diffstorm/WiFiMifareReader/README.md

# WiFiMifareReader
Wi-Fi featured IoT Mifare Card Reader with improved security and logging features
