diffstorm/WiFiMifareReader/HW/Reader/Images/door_lock_v1.1.png

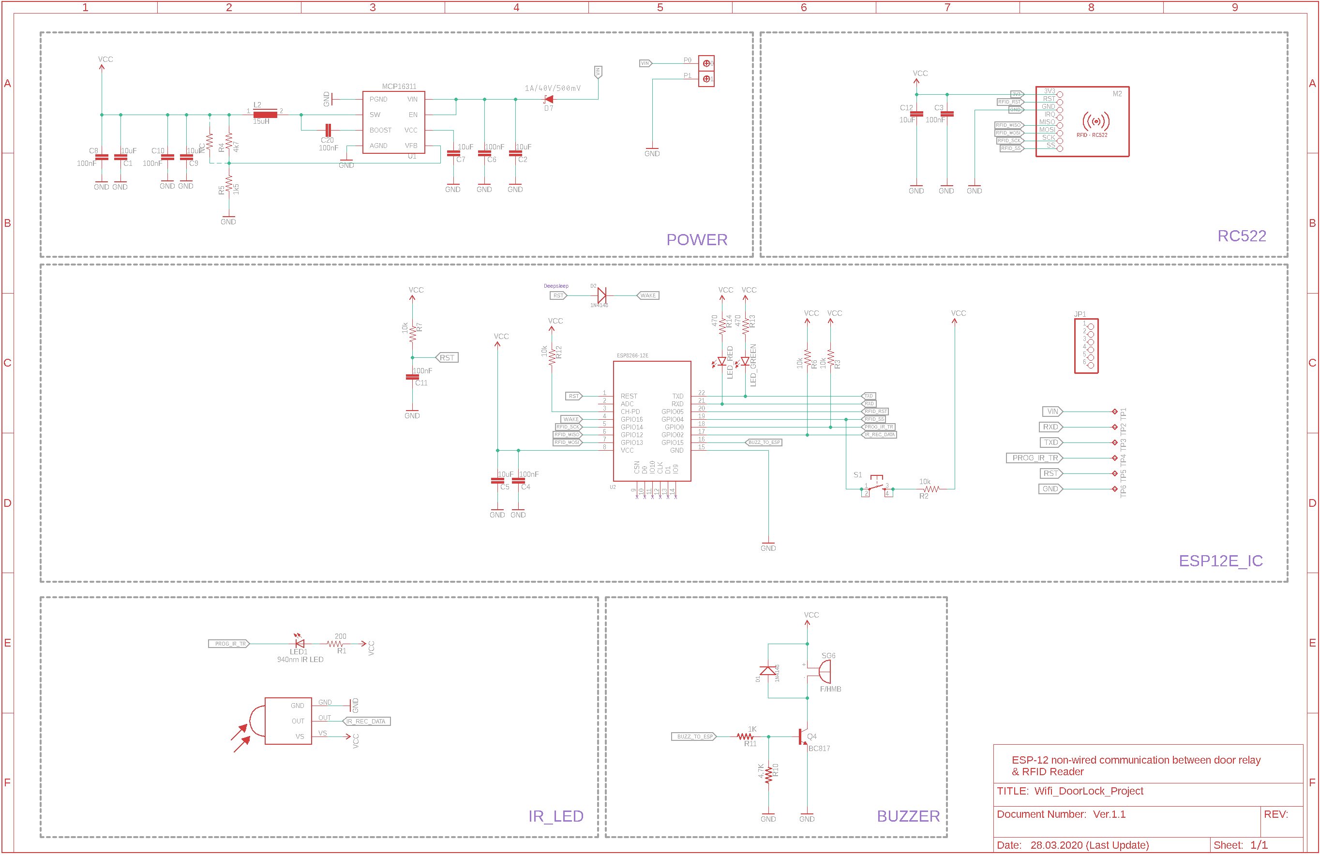
HW/Reader/Images/door_lock_v1.1.png
