diffstorm/WiFiMifareReader/HW/Relay/Images/Relay_schematic.png

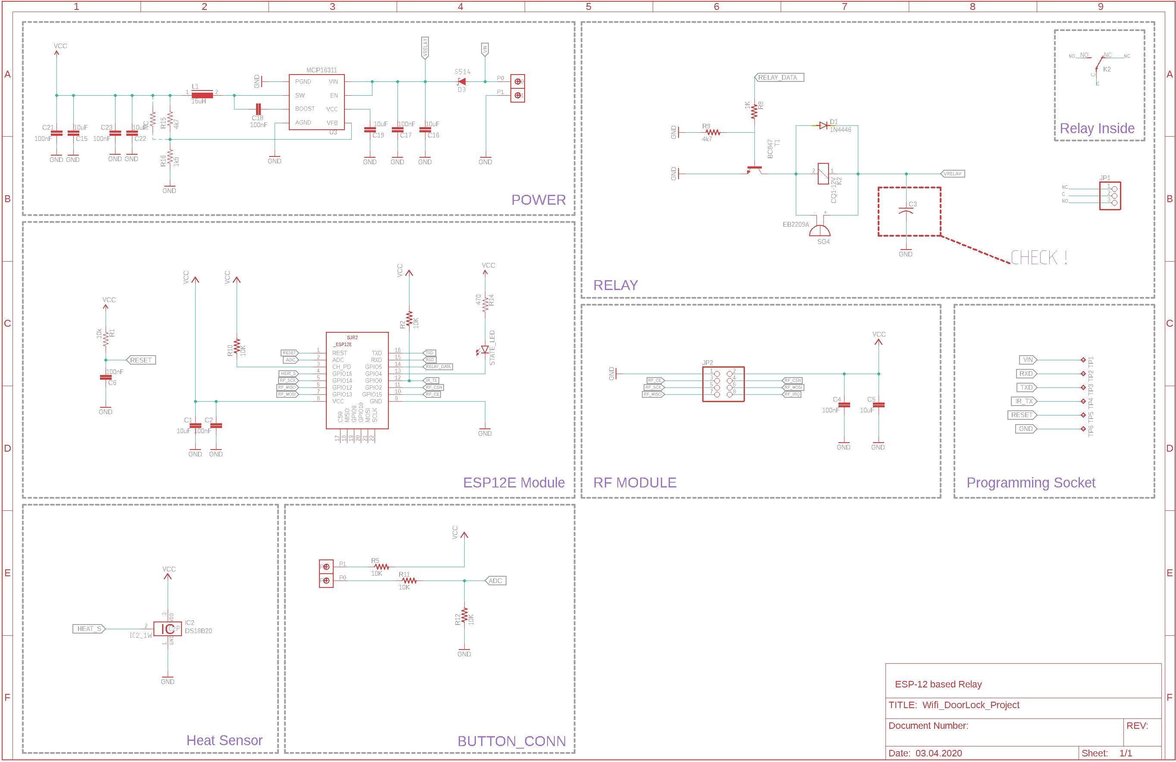
HW/Relay/Images/Relay_schematic.png
