diffstorm/WiFiMifareReader/HW/Reader/Eagle/flasher.brd

## EAGLE design HW/Reader/Eagle/flasher.brd (2020-04-13)

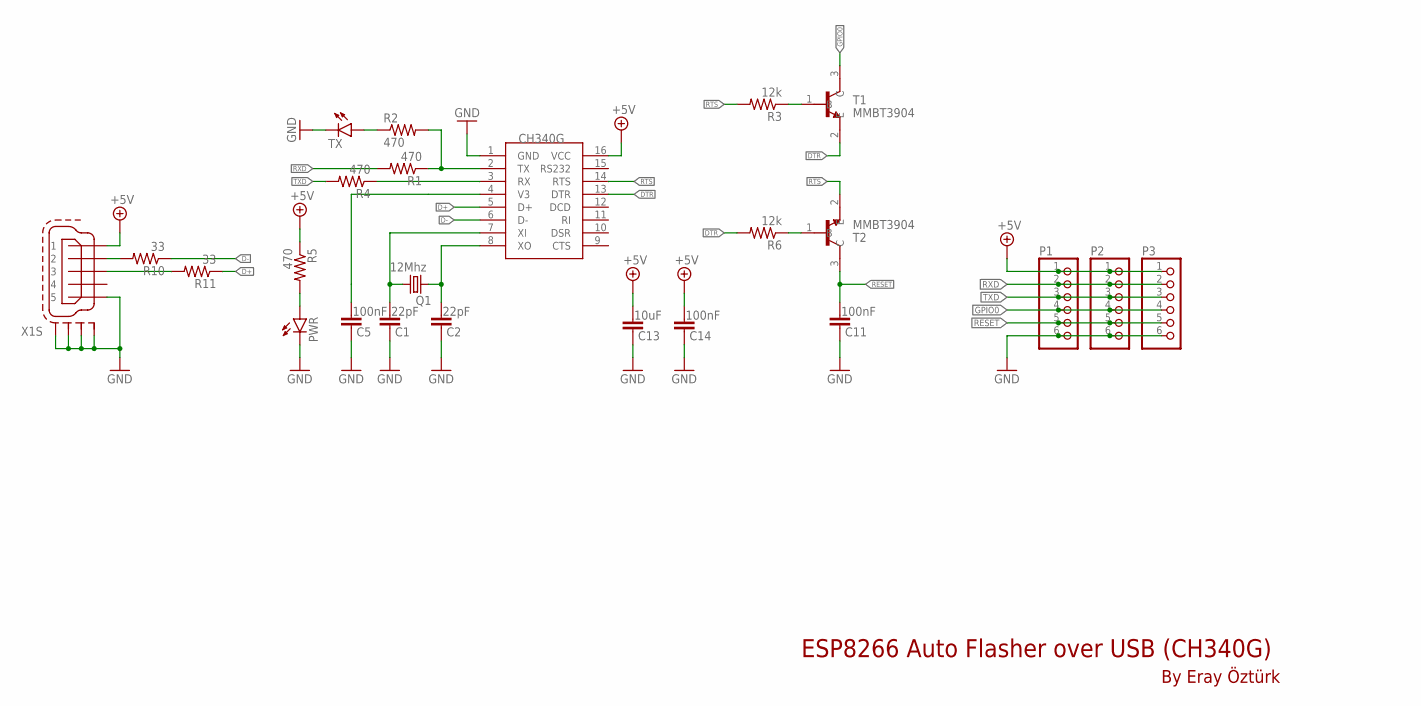
[picture p9: schematic flasher.sch]

Parts:
C1, C2: 22pF; C0805
C5, C11, C14: 100nF; C0805
C13: 10uF; C0805
P1, P2, P3: PINHD-1X6; 1X06
PWR: LEDCHIP-LED0805; CHIP-LED0805
Q1: 12Mhz; HC49/S
R1, R2, R4, R5: 470; M0805
R3, R6: 12k; M0805
R10, R11: 33; M0805
T1, T2: MMBT3904; SOT95P240X120-3N
TX: LEDCHIP-LED0805; CHIP-LED0805
U1: CH340G; SOIC16
X1: MINI-USB-SCHIELD-32005-201; 32005-201

Connections:
+5V: C13.2, C14.2, P1.1, P2.1, P3.1, R5.1, U1.16 (VCC), X1.1
D+: R11.1, U1.5 (D+)
D-: R10.1, U1.6 (D-)
DTR: R6.2, T1.2 (E), U1.13 (DTR)
GND: C1.1, C2.1, C5.1, C11.1, C13.1, C14.1, P1.6, P2.6, P3.6, PWR.C, TX.C, U1.1 (GND), X1.5, X1.M1 (S1), X1.M2 (S2), X1.M3 (S3), X1.M4 (S4)
GPIO0: P1.4, P2.4, P3.4, T1.3 (C)
unnamed: R1.1, R2.2, U1.2 (TX)
unnamed: R4.1, U1.3 (RX)
unnamed: PWR.A, R5.2
unnamed: R2.1, TX.A
unnamed: R3.1, T1.1 (B)
unnamed: R6.1, T2.1 (B)
unnamed: R10.2, X1.2
unnamed: R11.2, X1.3
unnamed: C5.2, U1.4 (V3)
unnamed: C1.2, Q1.1, U1.7 (XI)
unnamed: C2.2, Q1.2, U1.8 (XO)
RESET: C11.2, P1.5, P2.5, P3.5, T2.3 (C)
RTS: R3.2, T2.2 (E), U1.14 (RTS)
RXD: P1.2, P2.2, P3.2, R1.2
TXD: P1.3, P2.3, P3.3, R4.2

Notes on the sheet:
ESP8266 Auto Flasher over USB (CH340G)
By Eray Öztürk

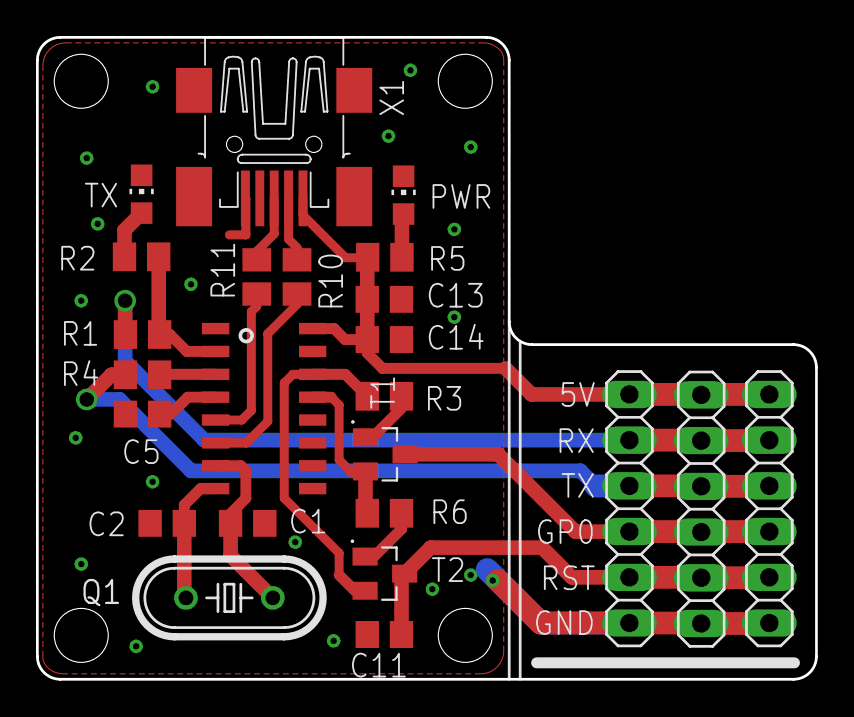
[picture p10: board flasher.brd from above]

Board: 2 copper layers, 43.3 x 35.7 mm, 24 parts (0 on the bottom side), 21 nets.
