diffstorm/WiFiMifareReader/HW/Relay/Eagle/relay.sch

## EAGLE design HW/Relay/Eagle/relay.sch (2020-04-29)

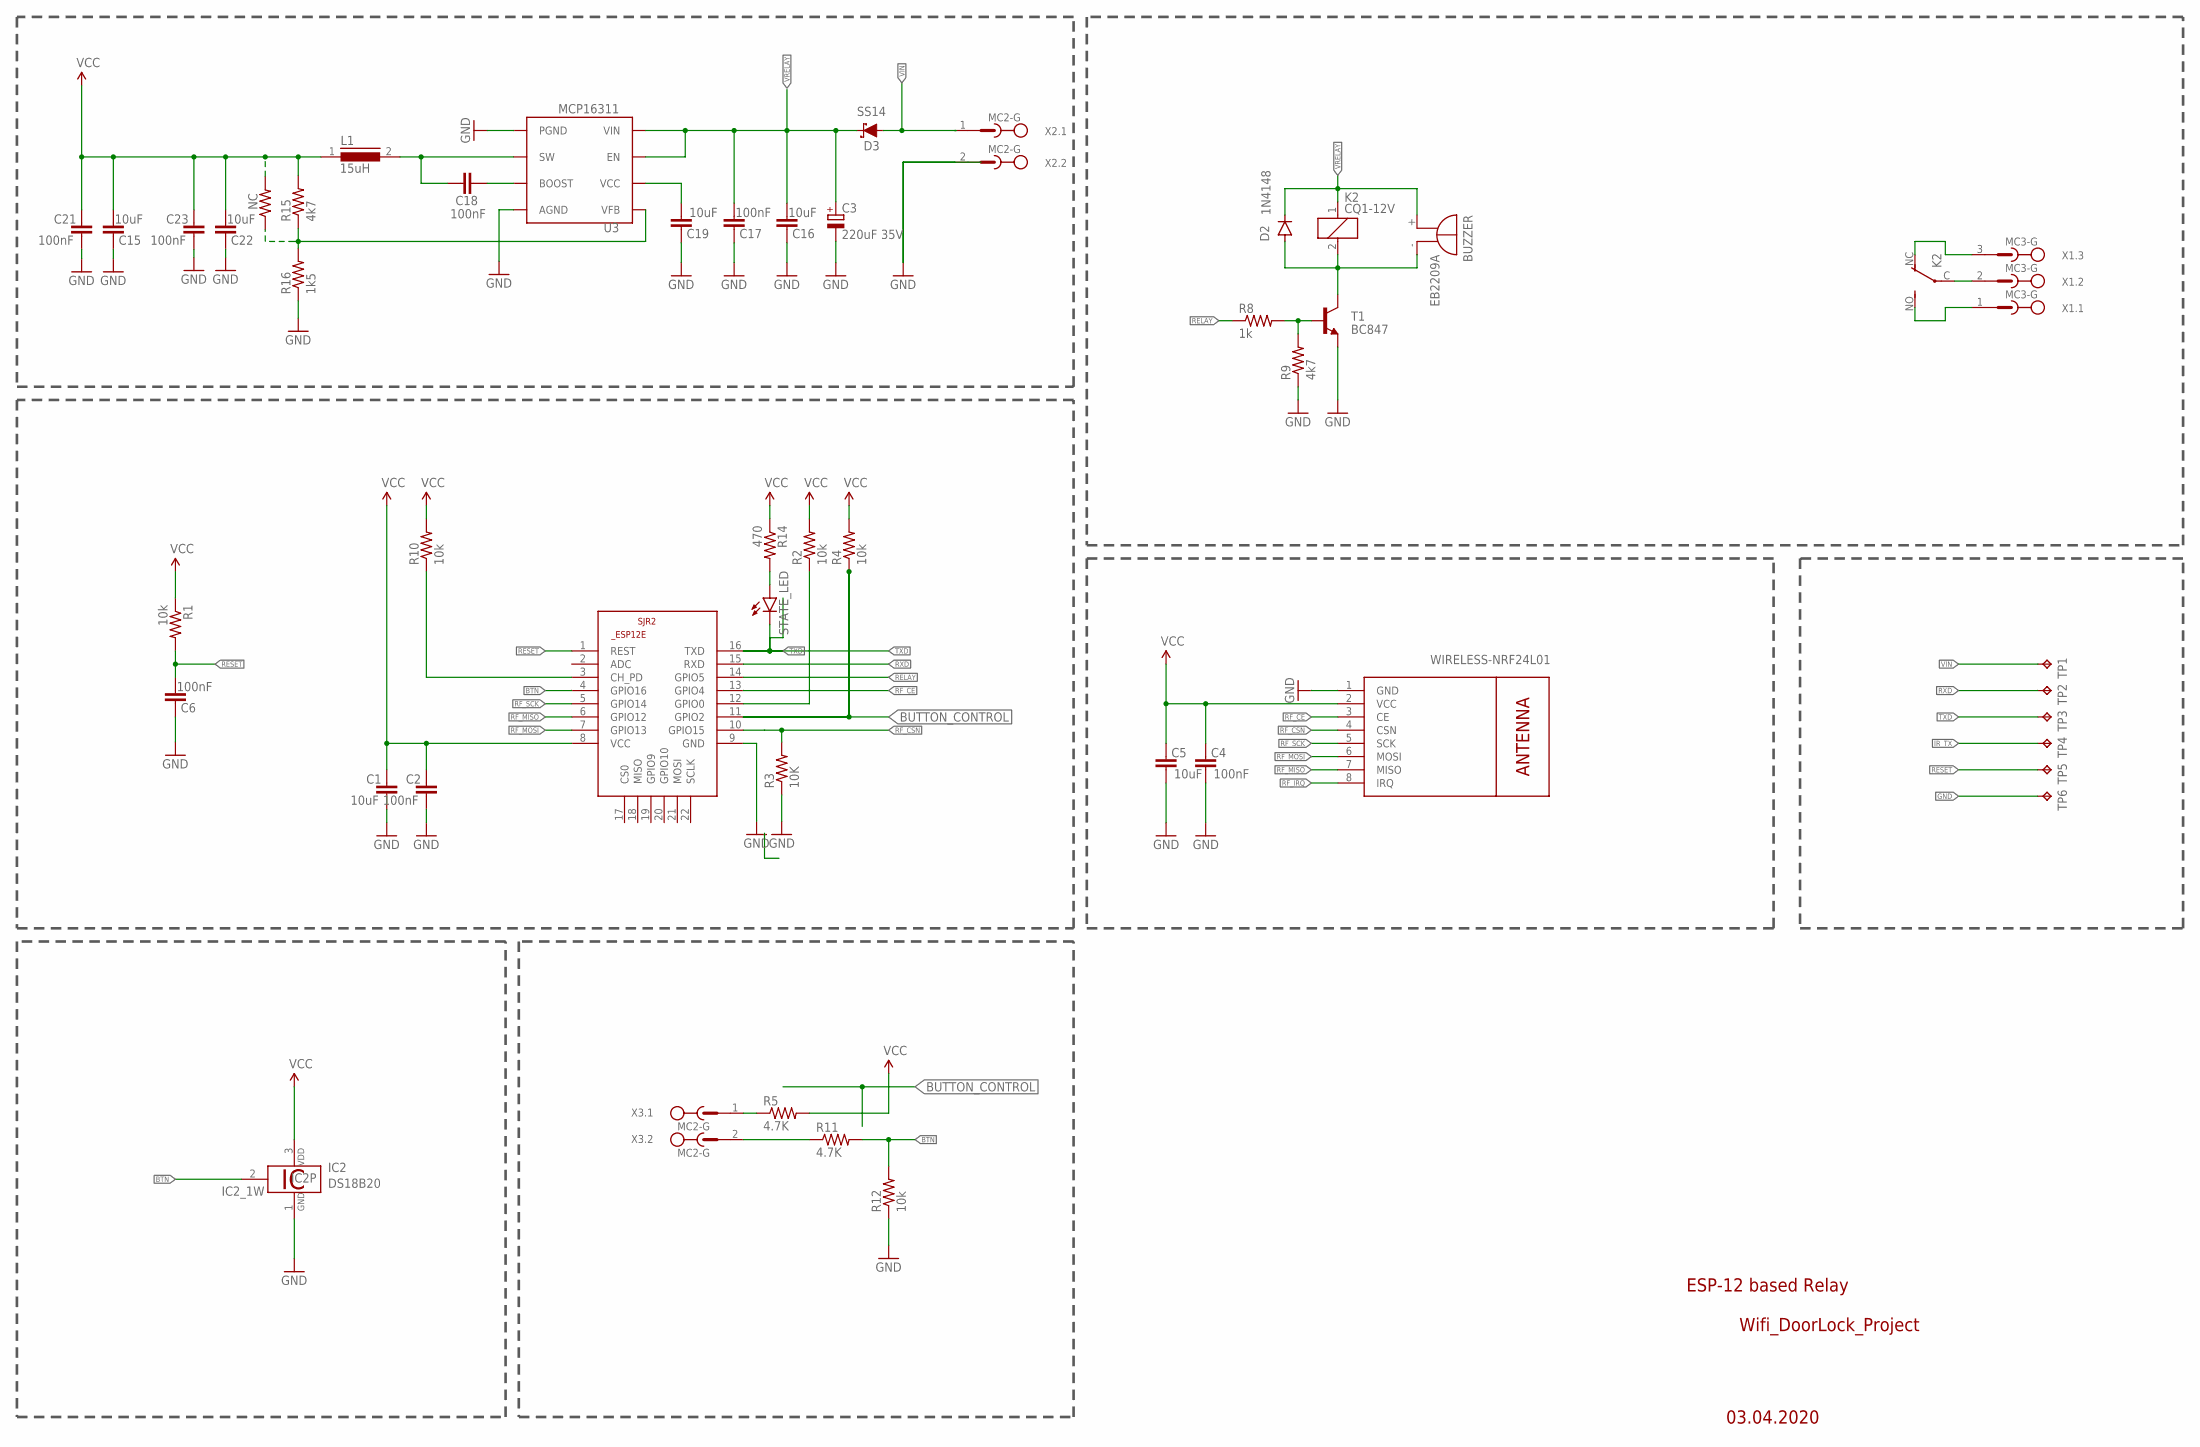
[picture p11: schematic relay.sch]

Parts:
BUZZER: EB2209A
C1, C5, C15, C16, C19, C22: 10uF; C0805
C2, C4, C6, C17, C18, C21, C23: 100nF; C0805
C3: 220uF 35V; 150CLZ-0810
D2: 1N4148; DO-214AC
D3: SS14; SMA-DIODE
IC2: DS18B20; TO92-
K2: CQ1-12V; CQ1
L1: 15uH; DR74
M1: WIRELESS-NRF24L01
NC: R-US_M0805; M0805
R1, R2, R4, R10, R12: 10k; M0805
R3: 10K; M0805
R5, R11: 4.7K; M0805
R8: 1k; M0805
R9, R15: 4k7; M0805
R14: 470; M0805
R16: 1k5; M0805
SJR2: ESP8266-12EESP12E; ESP8266-ESP12E
STATE_LED: LED3MM
T1: BC847; SOT23
TP1, TP2, TP3, TP4, TP5, TP6: TPTP20SQ; TP20SQ
U3: MCP16311; MSOP8
X1: MC3-G
X2, X3: MC2-G

Connections:
BTN: IC2.2 (1W), R11.2, R12.2, SJR2.4 (GPIO16)
BUTTON_CONTROL: R2.1, R11.2, R12.2, SJR2.11 (GPIO2)
G2: R4.1, SJR2.11 (GPIO2)
GND: C1.2, C2.2, C3.-, C4.2, C5.2, C6.1, C15.1, C16.1, C17.1, C19.1, C21.2, C22.1, C23.2, IC2.1 (GND), M1.1 (GND), R3.1, R9.1, R12.1, R16.1, SJR2.9 (GND), T1.2 (E), TP6.TP, U3.AGND, U3.PGND, X2.2
IR_TX: TP4.TP
unnamed: R8.2, R9.2, T1.1 (B)
unnamed: K2.C, X1.2
unnamed: NC.1, R15.1, R16.2, U3.VFB
unnamed: R14.2, STATE_LED.A
unnamed: BUZZER.-, D2.A, K2.2, T1.3 (C)
unnamed: K2.NC (O), X1.3
unnamed: K2.NO (S), X1.1
unnamed: R2.1, SJR2.12 (GPIO0)
unnamed: R5.1, X3.1
unnamed: R11.1, X3.2
unnamed: C18.2, L1.2, U3.SW
unnamed: C18.1, U3.BOOST
unnamed: C19.2, U3.VCC
unnamed: R10.1, SJR2.3 (CH_PD)
RELAY: R8.1, SJR2.14 (GPIO5)
RESET: C6.2, R1.2, SJR2.1 (REST), TP5.TP
RF_CE: M1.3 (CE), SJR2.13 (GPIO4)
RF_CSN: M1.4 (CSN), R3.2, SJR2.10 (GPIO15)
RF_IRQ: M1.8 (IRQ)
RF_MISO: M1.7 (MISO), SJR2.6 (GPIO12)
RF_MOSI: M1.6 (MOSI), SJR2.7 (GPIO13)
RF_SCK: M1.5 (SCK), SJR2.5 (GPIO14)
RXD: SJR2.15 (RXD), TP2.TP
TXD: SJR2.16 (TXD), STATE_LED.K (C), TP3.TP
VCC: C1.1, C2.1, C4.1, C5.1, C15.2, C21.1, C22.2, C23.1, IC2.3 (VDD), L1.1, M1.2 (VCC), NC.2, R1.1, R2.2, R4.2, R5.2, R10.2, R14.1, R15.2, SJR2.8 (VCC)
VIN: D3.A, TP1.TP, X2.1
VRELAY: BUZZER.+, C3.+, C16.2, C17.2, D2.C, D3.C, K2.1, U3.EN, U3.VIN

Notes on the sheet:
ESP-12 based Relay
Wifi_DoorLock_Project
03.04.2020
