diffstorm/WiFiMifareReader/SW/Reader/v1/src/DebugLog.cpp

#include <Arduino.h>
#include <DebugLog.h>

void DBG_LOG_Init(unsigned long baudrate)
{
    Serial.begin(baudrate);
}

// Printout: message [int, float, double, hex] | <function_name> @ <file_name> : <line>

void DBG_LOG_tail(const char *func, const char *loc)
{
    Serial.print(" | ");
    Serial.print(func);
    Serial.println(loc);
}

#if 0
void DBG_LOG(const char *message, const char *func, const char *loc, int *i, float *f, double *d, char *hex, int hex_size)
{
    Serial.print(message);
    if(NULL != i)
    {
        Serial.print(" ");
        Serial.print(*i);
    }
    else if(NULL != f)
    {
        Serial.print(" ");
        Serial.print(*f);
    }
    else if(NULL != d)
    {
        Serial.print(" ");
        Serial.print(*d);
    }
    else if(NULL != hex && 0 < hex_size)
    {
        Serial.print(" [");
        for(int i = 0; i < hex_size; i++)
        {
            Serial.printf("%02X", hex[i]);

            if(i + 1 < hex_size)
            {
                Serial.print(", ");
            }
        }
        Serial.print("]");
    }
    DBG_LOG_tail(func, loc);
}
#else
void DBG_LOG(const char *message, const char *func, const char *loc, dl_type_t type, void *in, int size)
{
    Serial.print(message);
    switch (type)
    {
    case dl_int:
        {
            int *i = (int *)in;
            Serial.print(" ");
            Serial.print(*i);
        }
        break;
    case dl_float:
        {
            float *f = (float *)in;
            Serial.print(" ");
            Serial.print(*f);
        }
        break;
    case dl_double:
        {
            double *d = (double *)in;
            Serial.print(" ");
            Serial.print(*d);
        }
        break;
    case dl_hex:
        {
            unsigned char *hex = (unsigned char *)in;
            if(NULL != hex && 0 < size)
            {
                Serial.print(" [");
                for(int i = 0; i < size; i++)
                {
                    Serial.printf("%02X", hex[i]);

                    if(i + 1 < size)
                    {
                        Serial.print(", ");
                    }
                }
                Serial.print("]");
            }
        }
        break;
    default:
        break;
    }
    DBG_LOG_tail(func, loc);
}
#endif
