diffstorm/WiFiMifareReader/(commit log)

2020-03-09 led ve buzzer eklendi
    [Buzzer.cpp, Buzzer.h, Reader.cpp, led.cpp, led.h, main.cpp]
2020-03-09 led ve buzzer duzenlemeleri yapildi
    [Buzzer.cpp, Reader.cpp, Reader.h, led.cpp, main.cpp]
2020-03-09 ledpinleri tanımlandı
2020-03-09 timer duzeltildi
2020-03-10 SysTimer adding for led and buzzer
    [Buzzer.cpp, Buzzer.h, SysTick.cpp, led.cpp]
2020-03-10 led and buzzer solved
    [Buzzer.cpp, Buzzer.h, Reader.cpp, SysTick.cpp, led.cpp, main.cpp]
2020-03-11 Add files via upload
    Malzeme Listesi ve IR led dökümanları eklendi.
2020-03-12 eagle schematic is uploaded
    Eagle sch. documents only included reader and programmable part of first step.
    [PROG.sch, door_lock_v1.0.sch]
2020-03-28 Delete v1.0
    swap files with latest update v1.1
    [door_lock_v1.0.sch]
2020-03-28 swap files with lastest update v1.1
    [door_lock_v1.1.sch]
2020-03-28 WiFiReaderConfig - Add relay comm method
2020-03-28 Relay_config dosyası oluşturuldu.
2020-03-28 RelayConfig Değişti
2020-04-02 deleted old version of programming sch.
    [PROG.sch]
2020-04-02 deleted version of door_locks v1.1 sch.
    [door_lock_v1.1.sch]
2020-04-02 wifi_reader, program_reader sch. is changed
    Programlama pinleri değiştirildi, eklendi. door_lock_v1.2.sch üzerinde hatalar düzeltildir. Footprintler kontrol edildi.
    [door_lock_v1.2.sch, program_v1.2.sch]
2020-04-02 Minor improvements on schematic
    [door_lock_v1.2.sch]
2020-04-03 relay_sch updated.
    Relay sch, Programming sch, sch. image are updated.
    [program_v1.2.sch, relay.sch]
2020-04-03 deleting relay.pro
    not usable for now.
2020-04-03 Delete relay.brd
    Not prepared for now
    [relay.brd]
2020-04-03 Add DeviceConfig
2020-04-03 Update relay.sch
    NRF24L01 module has changed.
    [relay.sch]
2020-04-05 Add DeviceConfig API
2020-04-06 Replace DateTime_t based time variables with UTC ones
    [Card.cpp, Card.h, CardConfig.h, Device.cpp, Device.h, DeviceConfig.h, tools.cpp, tools.h]
2020-04-07 [Fix] Bugfix on Read/Write into card sectors
    [Card.cpp]
2020-04-09 Relay schematic improved
    [relay.sch]
2020-04-11 Schematics are updated
    Kickstart flasher PCB
    [flasher.brd, flasher.sch, program_v1.2.sch, reader.sch, relay.sch]
2020-04-12 Flasher CH340G SCH & PCB
    [flasher.brd, flasher.sch]
2020-04-13 Flasher Update
    [flasher.brd, flasher.sch]
2020-04-17 filesystem ve whitelist
    Whitelist daha fail safe yapılmadı. Testlerde calıstığı görüldü. (Testler detaylı yapılmadı).
    [FileSystem.cpp, FileSystem.h, whitelist.cpp, whitelist.h]
2020-04-27 Debug log improved. Use LOGp as printf
    IR disabled
    duplicated example functions renamed
